ahmetakcay06/Mechanical-Engineering-Final-Year-Project/Robotic_Gripper_Poster.jpeg

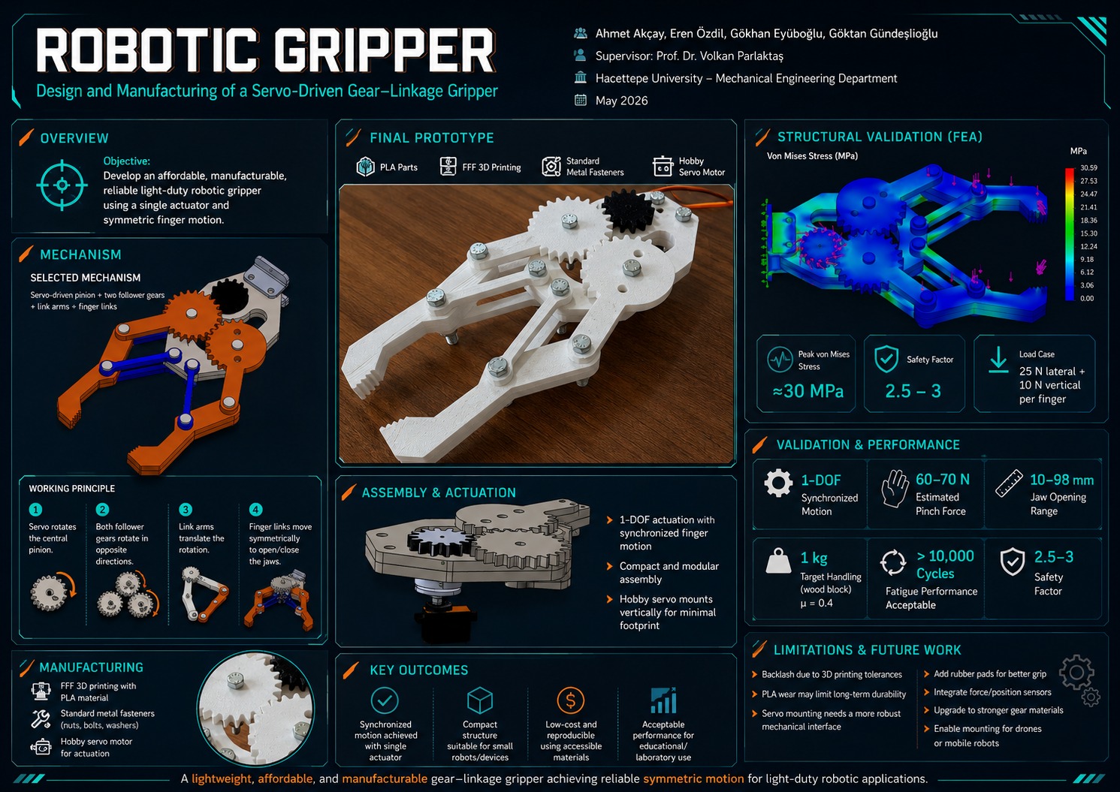
Robotic_Gripper_Poster.jpeg
