ahmetakcay06/Mechanical-Engineering-Final-Year-Project/README.md

# Mechanical-Engineering-Final-Year-Project
This repo has created to demonstrate my final year project and effort.
