ahmetakcay06/Mechanical-Engineering-Final-Year-Project/Scale edilmiş robotic Gripper/Motor/EMax ES08MAII Servo.jpg

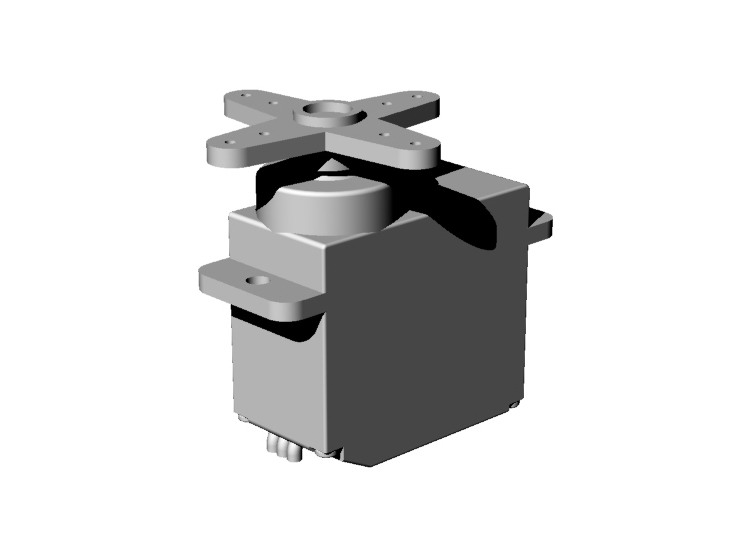
Scale edilmiş robotic Gripper/Motor/EMax ES08MAII Servo.jpg
