ahmetakcay06/Mechanical-Engineering-Final-Year-Project/Scale edilmiş robotic Gripper/Montaj1_Efehan.SLDASM

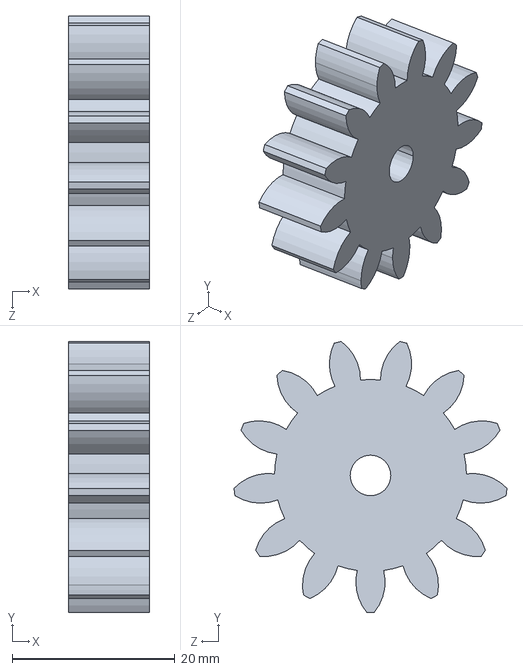
[picture p35: CAD file, 2026-08-01]
Scale edilmiş robotic Gripper/Montaj1_Efehan.SLDASM
10.0 x 33.4 x 33.6 mm
