ahmetakcay06/Mechanical-Engineering-Final-Year-Project/Scale edilmiş robotic Gripper/assembly2x_deneme.stp

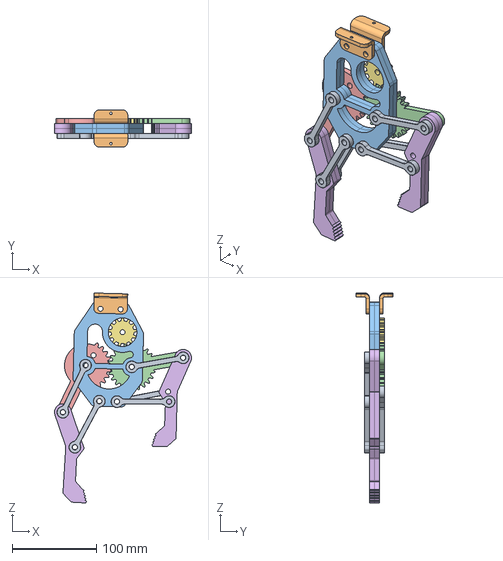
[picture p36: CAD file, 2026-08-01]
Scale edilmiş robotic Gripper/assembly2x_deneme.stp
162.9 x 44.0 x 249.7 mm
