ahmetakcay06/Mechanical-Engineering-Final-Year-Project/Scale edilmiş robotic Gripper/scale2x step/01- GARRA.STEP.SLDASM

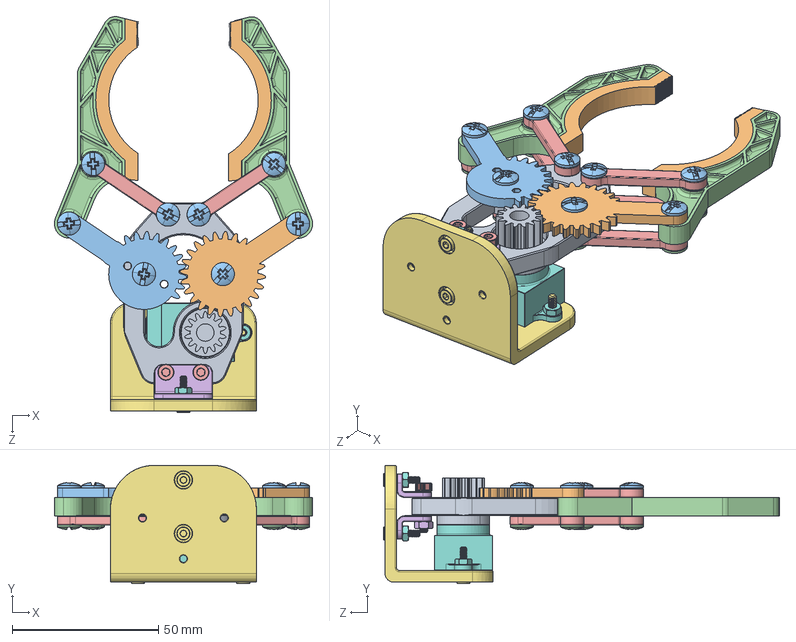
[picture p37: CAD file, 2026-08-01]
Scale edilmiş robotic Gripper/scale2x step/01- GARRA.STEP.SLDASM
88.4 x 40.5 x 135.6 mm
05- SUPORTE DA GARRA.STEP
07 - ENGRENAGEM COMPLETA 01.STEP
08- ENGRENAGEM PARCIAL.STEP
06- DEDO DA GARRA.STEP x 2
02 - LIGAÇÃO DA GARRA.STEP x 6
03- SUPORTE FIXADOR (L).STEP x 2
01- MESA FIXADORA DA GARRA.STEP
04 - MOTOR DE GIRO 01.STEP
10-ENGRENAGEM PINHAO.STEP
09- BORRACHA DE PROTECAO.STEP x 2
PARAFUSO DE LIGAÇÃO ROSCA INTERNA 0.5inch.STEP x 8
PARAFUSO ROSCADO.STEP x 8
PARAFUSO ALLEN m3x0.5 14mm.STEP x 2
PORCA SEXTAVADA m3x0.5.STEP x 2
PARAFUSO ALLEN m2.5x0.45 10mm.STEP x 4
PORCA SEXTAVADA m2.5x0.45.STEP x 4
