ahmetakcay06/Mechanical-Engineering-Final-Year-Project/Scale edilmiş robotic Gripper/Motor/EMax ES08MAII Servo.stp

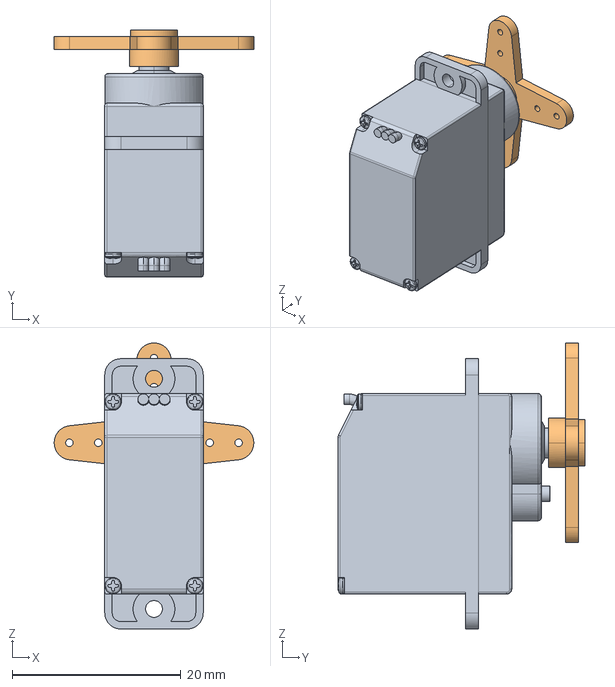
[picture p38: CAD file, 2026-08-01]
Scale edilmiş robotic Gripper/Motor/EMax ES08MAII Servo.stp
23.7 x 29.3 x 33.9 mm
