ahmetakcay06/Mechanical-Engineering-Final-Year-Project/Scale edilmiş robotic Gripper/scale2x step/Base Gear.STEP

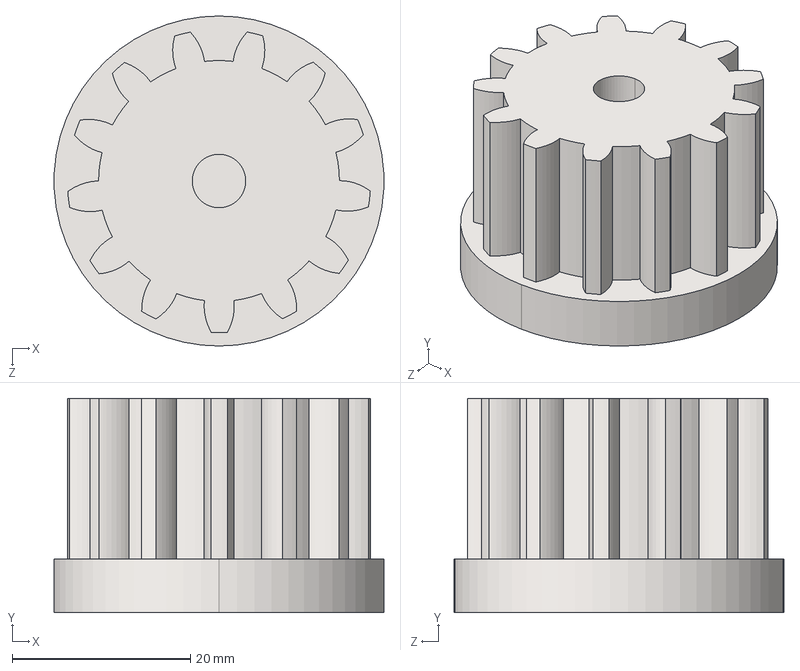
[picture p39: CAD file, 2026-08-01]
Scale edilmiş robotic Gripper/scale2x step/Base Gear.STEP
36.9 x 24.0 x 37.0 mm
