ahmetakcay06/Mechanical-Engineering-Final-Year-Project/Scale edilmiş robotic Gripper/Servo EMAX ES08MAII.stp

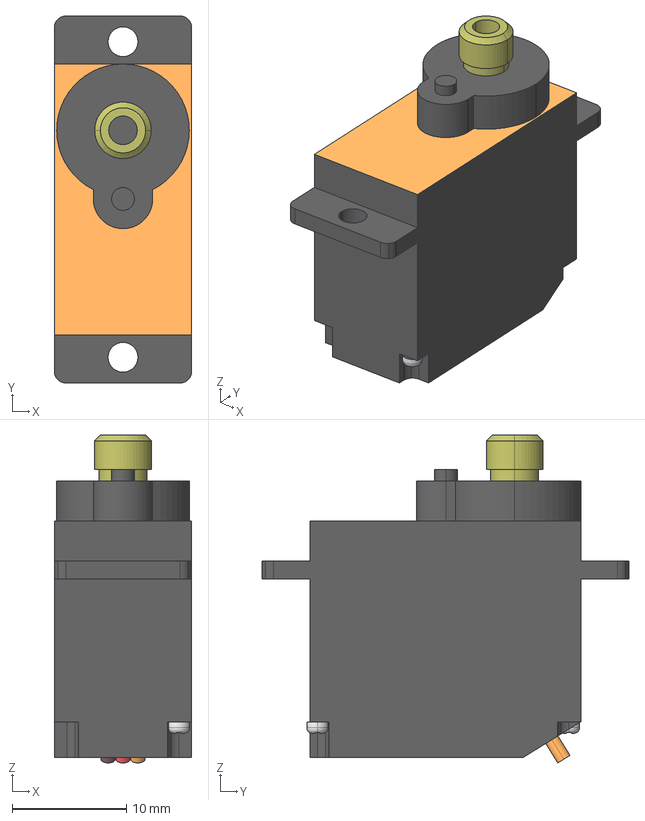
[picture p40: CAD file, 2026-08-01]
Scale edilmiş robotic Gripper/Servo EMAX ES08MAII.stp
12.0 x 32.1 x 28.7 mm
