ahmetakcay06/Mechanical-Engineering-Final-Year-Project/Scale edilmiş robotic Gripper/Base Plate.SLDPRT

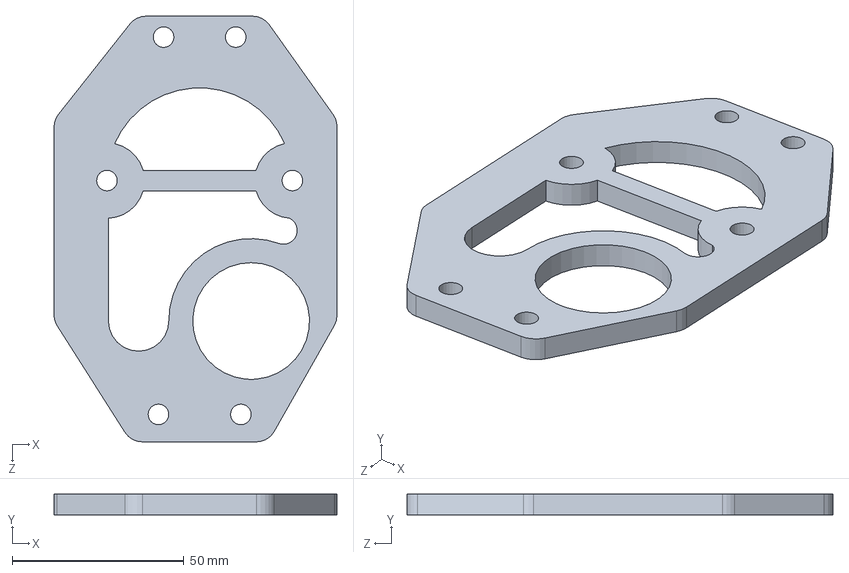
[picture p41: CAD file, 2026-08-01]
Scale edilmiş robotic Gripper/Base Plate.SLDPRT
82.4 x 6.00 x 124.0 mm
