ahmetakcay06/Mechanical-Engineering-Final-Year-Project/Scale edilmiş robotic Gripper/scale2x step/Gripper.STEP

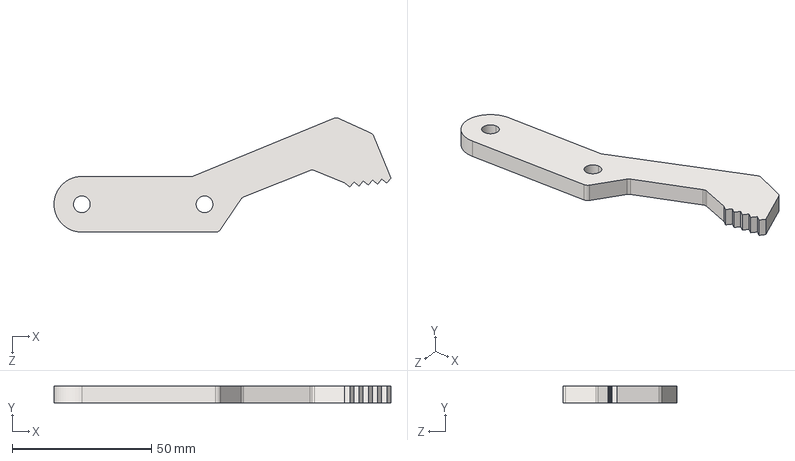
[picture p42: CAD file, 2026-08-01]
Scale edilmiş robotic Gripper/scale2x step/Gripper.STEP
120.9 x 6.00 x 41.0 mm
