ahmetakcay06/Mechanical-Engineering-Final-Year-Project/Scale edilmiş robotic Gripper/Base Gear.SLDPRT

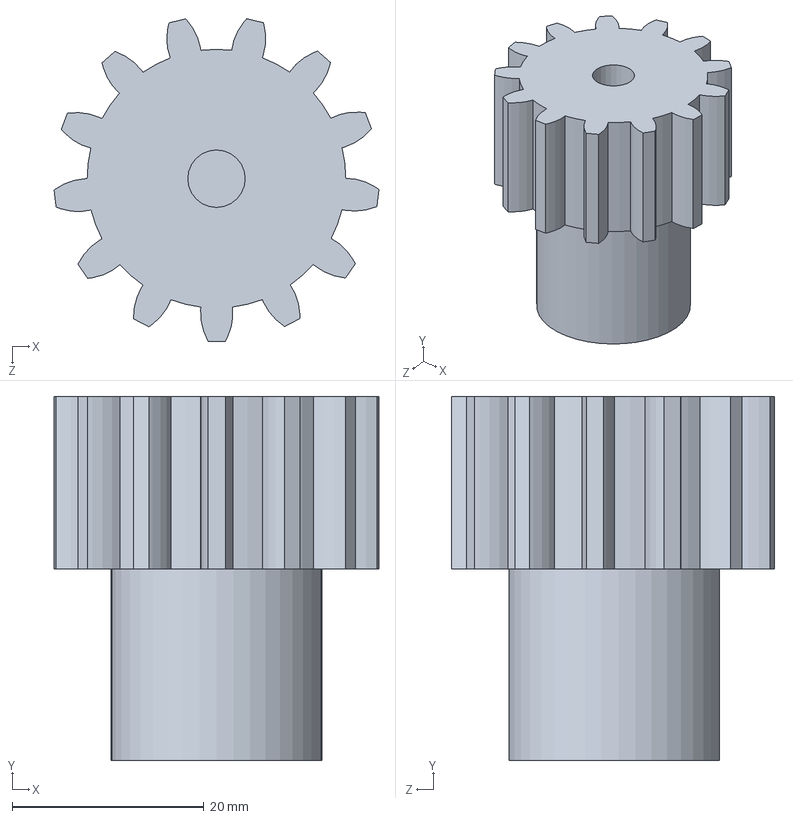
[picture p43: CAD file, 2026-08-01]
Scale edilmiş robotic Gripper/Base Gear.SLDPRT
33.9 x 38.0 x 33.7 mm
