ahmetakcay06/Mechanical-Engineering-Final-Year-Project/Scale edilmiş robotic Gripper/scale2x step/Gear Link 2.STEP

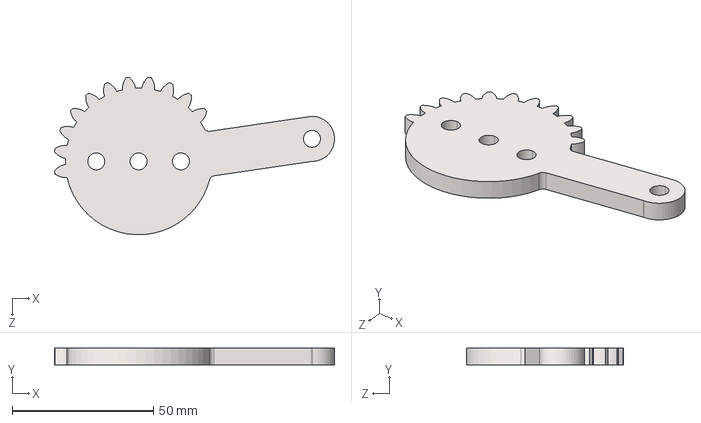
[picture p44: CAD file, 2026-08-01]
Scale edilmiş robotic Gripper/scale2x step/Gear Link 2.STEP
99.3 x 6.00 x 55.8 mm
