ahmetakcay06/Mechanical-Engineering-Final-Year-Project/Scale edilmiş robotic Gripper/scale2x step/Gear Link 1.STEP

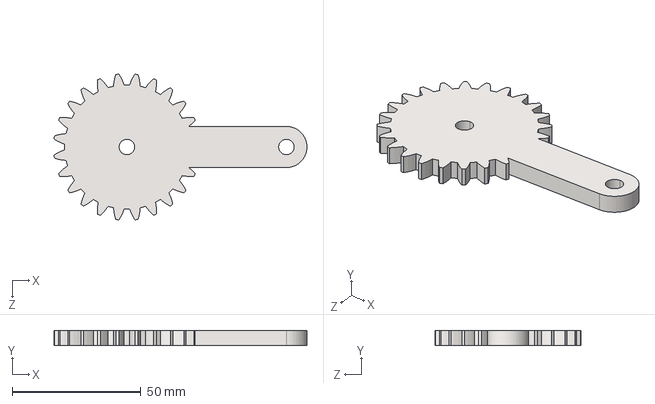
[picture p45: CAD file, 2026-08-01]
Scale edilmiş robotic Gripper/scale2x step/Gear Link 1.STEP
98.3 x 6.00 x 56.7 mm
