ahmetakcay06/Mechanical-Engineering-Final-Year-Project/Scale edilmiş robotic Gripper/scale2x step/pin.STEP

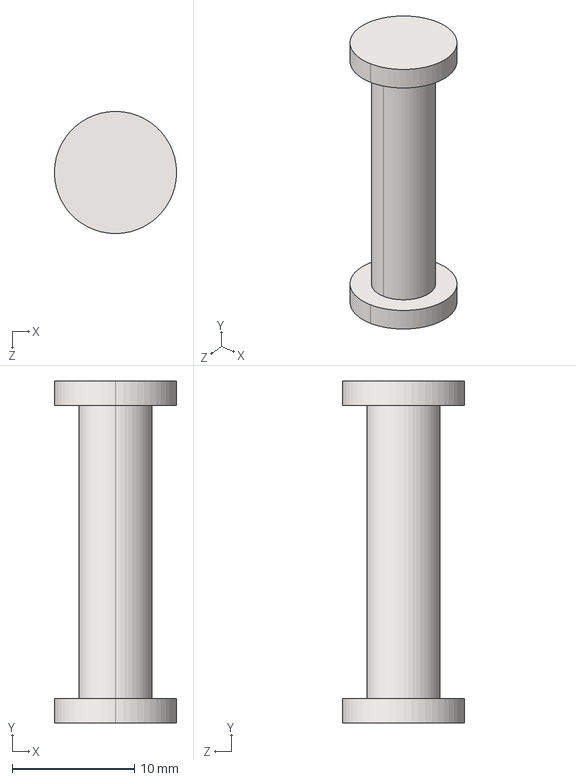
[picture p46: CAD file, 2026-08-01]
Scale edilmiş robotic Gripper/scale2x step/pin.STEP
10.0 x 28.0 x 10.0 mm
