ahmetakcay06/Mechanical-Engineering-Final-Year-Project/Scale edilmiş robotic Gripper/link.SLDPRT

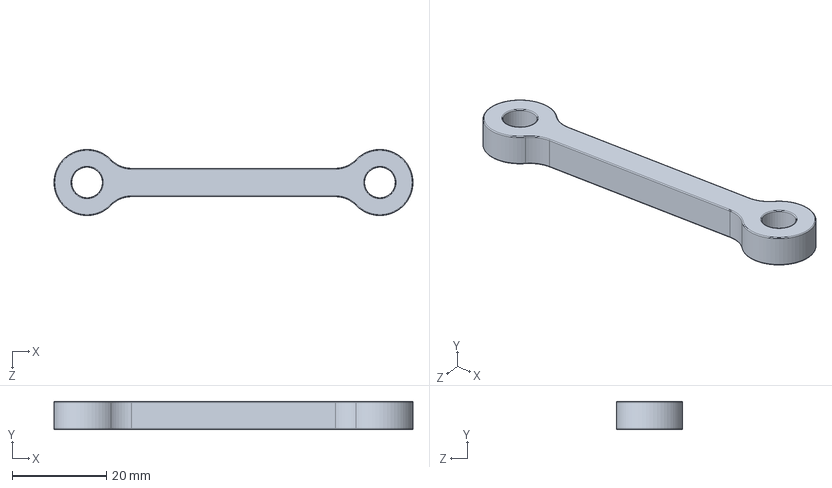
[picture p47: CAD file, 2026-08-01]
Scale edilmiş robotic Gripper/link.SLDPRT
76.0 x 6.00 x 14.0 mm
