ahmetakcay06/Mechanical-Engineering-Final-Year-Project/Scale edilmiş robotic Gripper/scale2x step/Robot Gripper.STEP

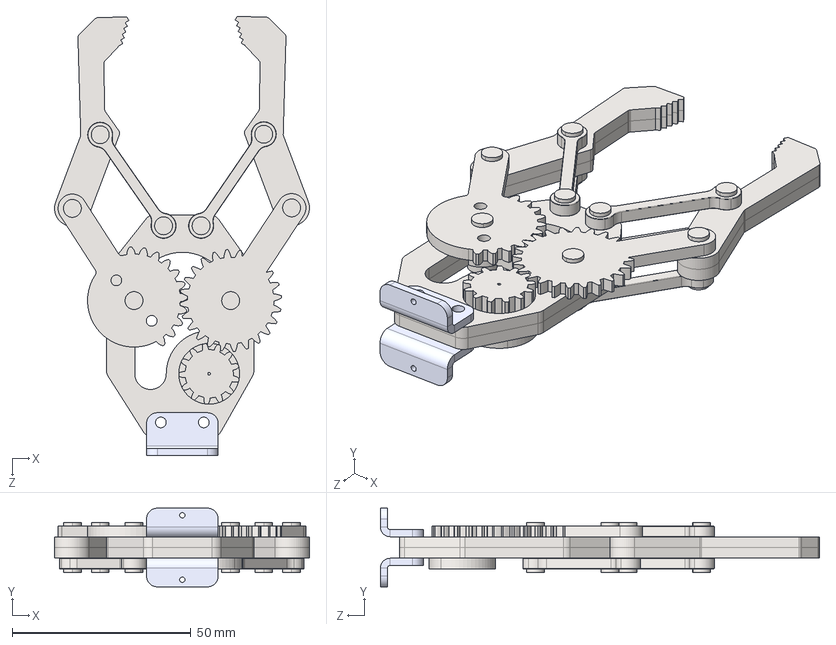
[picture p48: CAD file, 2026-08-01]
Scale edilmiş robotic Gripper/scale2x step/Robot Gripper.STEP
71.3 x 22.0 x 122.8 mm
Base Plate.STEP x 2
Base Gear.STEP
Base Mounting Bracket.STEP x 2
Gripper.STEP x 4
Gear Link 1.STEP
link.STEP x 6
pin.STEP x 8
Gear Link 2.STEP
