ahmetakcay06/Mechanical-Engineering-Final-Year-Project/Scale edilmiş robotic Gripper/Base Mounting Bracket.SLDPRT

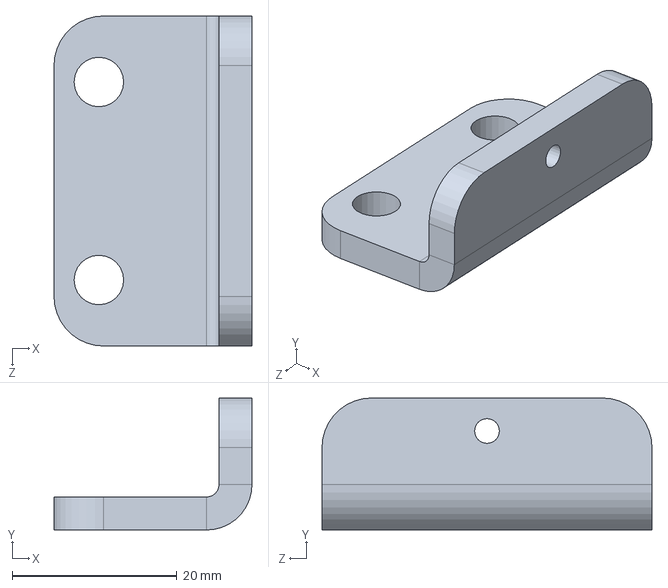
[picture p49: CAD file, 2026-08-01]
Scale edilmiş robotic Gripper/Base Mounting Bracket.SLDPRT
24.0 x 16.0 x 40.0 mm
