ahmetakcay06/Mechanical-Engineering-Final-Year-Project/Scale edilmiş robotic Gripper/Base Plate_15mm_version.SLDPRT

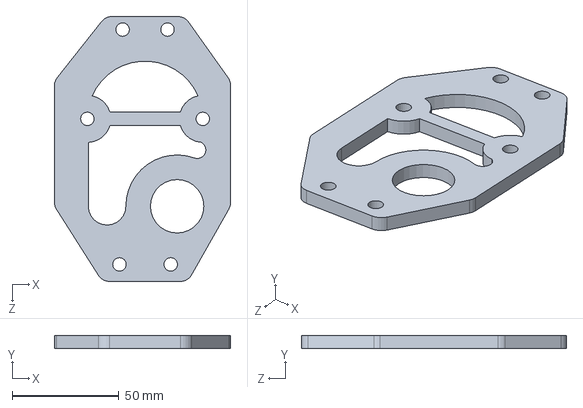
[picture p50: CAD file, 2026-08-01]
Scale edilmiş robotic Gripper/Base Plate_15mm_version.SLDPRT
82.4 x 6.00 x 124.0 mm
