ahmetakcay06/Mechanical-Engineering-Final-Year-Project/(list of files, cad)

Other CAD files:
Scale edilmiş robotic Gripper/Gear Link 2.SLDPRT
Scale edilmiş robotic Gripper/Gear Link 1.SLDPRT
Scale edilmiş robotic Gripper/scale2x step/Base Plate.STEP
Scale edilmiş robotic Gripper/scale2x step/Base Mounting Bracket.STEP
Scale edilmiş robotic Gripper/Gripper.SLDPRT
Scale edilmiş robotic Gripper/scale2x step/link.STEP
Scale edilmiş robotic Gripper/assembly2x_deneme.SLDASM
